jeffqchen/386DX_QFP_PGA_Adapter/3D Print/386 Pin Assembly Jig.stl

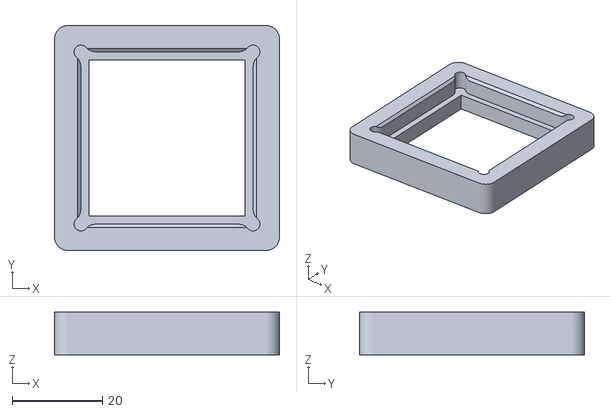
[picture p11: CAD file, 2026-06-11]
3D Print/386 Pin Assembly Jig.stl
50.0 x 50.0 x 9.45
