jeffqchen/386DX_QFP_PGA_Adapter/3D Print/386 Paste Jig.stl

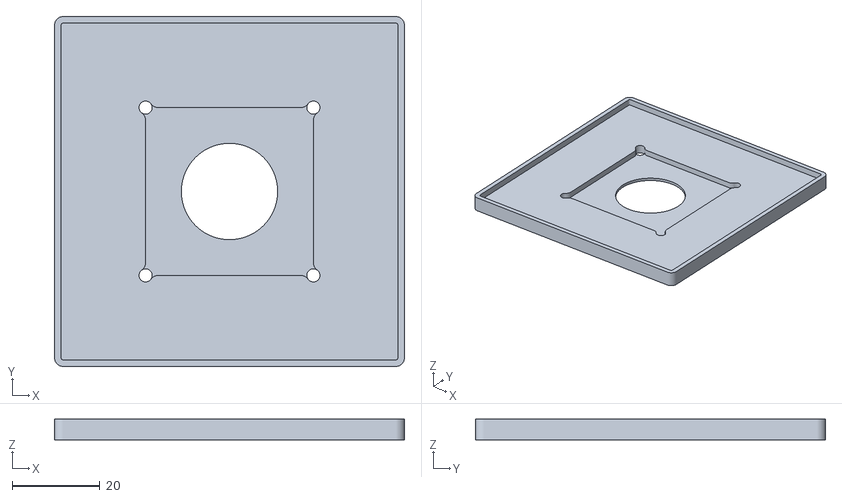
[picture p12: CAD file, 2026-06-11]
3D Print/386 Paste Jig.stl
80.0 x 80.0 x 4.70
