jeffqchen/386DX_QFP_PGA_Adapter/(commit log)

2026-06-11 Create readme for 3D printed jigs
    Added a readme file detailing 3D printed jigs used in the project.
2026-06-11 Update readme with jigs and assembly notes
    Added images and details for jigs used in CPU assembly.
2026-06-12 Enhance readme with detailed jig instructions
    Expanded the readme to include detailed instructions on jigs usage, printing, and troubleshooting tips.
2026-06-12 Refine PCB handling and troubleshooting instructions
    Updated instructions for inspecting and releasing PCBs from jigs, and clarified troubleshooting tips for loose pins after soldering.
